cyril-bruch/desk-companion-robot/cad/print/PLATEAU_4_roues_sans_supports.stl

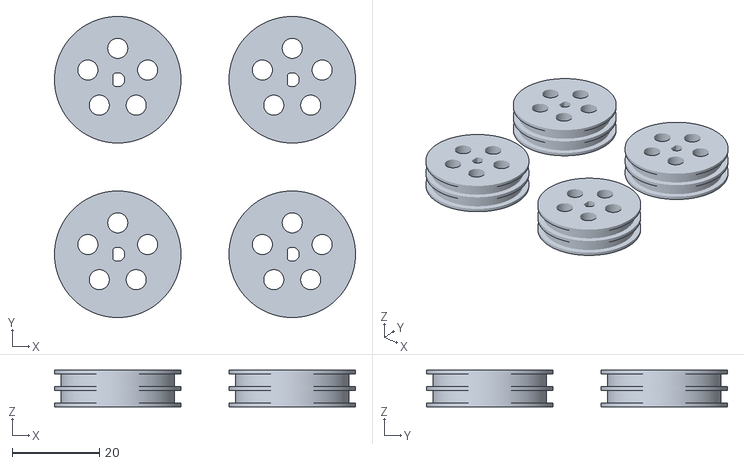
[picture p7: CAD file, 2026-10-27]
cad/print/PLATEAU_4_roues_sans_supports.stl
69.0 x 69.0 x 8.40
