cyril-bruch/desk-companion-robot/cad/print/PLATEAU_2_chassis_roues_capots.stl

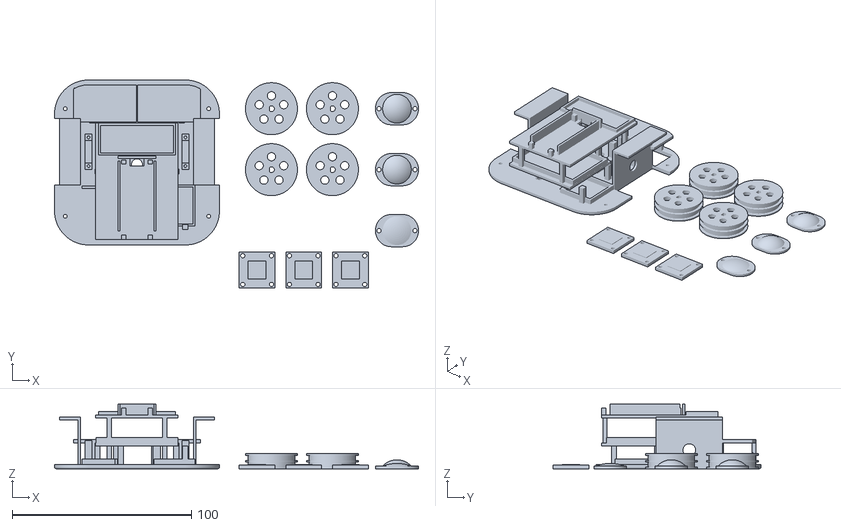
[picture p8: CAD file, 2026-10-24]
cad/print/PLATEAU_2_chassis_roues_capots.stl
203.0 x 116.0 x 36.0
