cyril-bruch/desk-companion-robot/cad/print/6b_patin_pour_feutre_2mm.stl

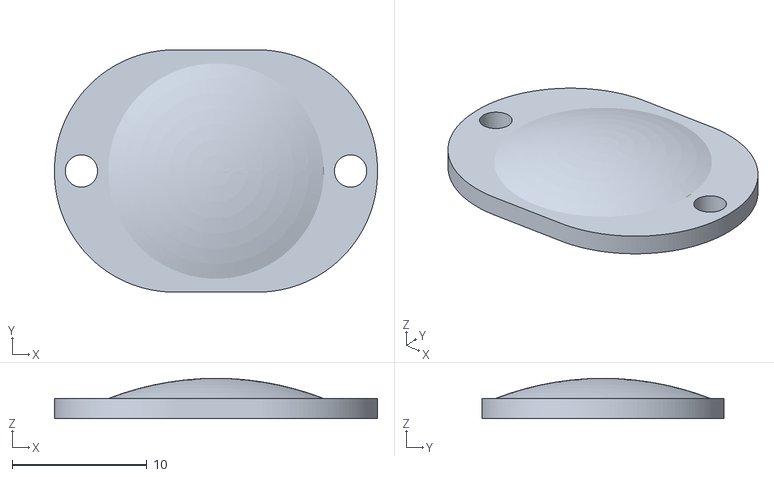
[picture p9: CAD file, 2026-10-24]
cad/print/6b_patin_pour_feutre_2mm.stl
24.0 x 18.0 x 3.00
