cyril-bruch/desk-companion-robot/cad/print/1_coque.stl

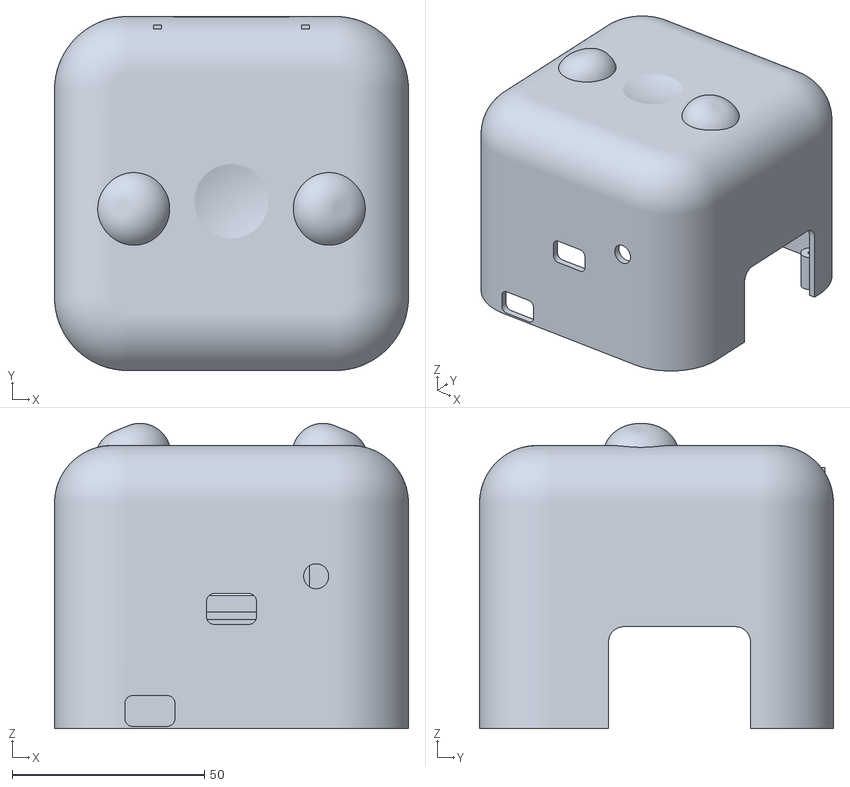
[picture p10: CAD file, 2026-10-24]
cad/print/1_coque.stl
92.0 x 92.0 x 79.3
