cyril-bruch/desk-companion-robot/cad/print/5_capot_moteur_x3.stl

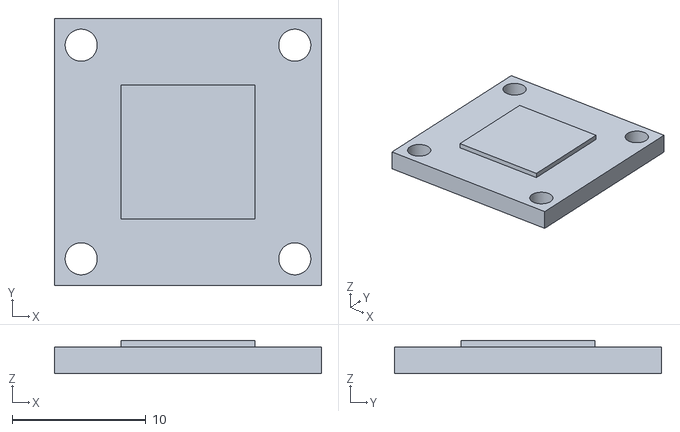
[picture p11: CAD file, 2026-10-24]
cad/print/5_capot_moteur_x3.stl
20.0 x 20.0 x 2.50
