cyril-bruch/desk-companion-robot/cad/print/4_roue_x4.stl

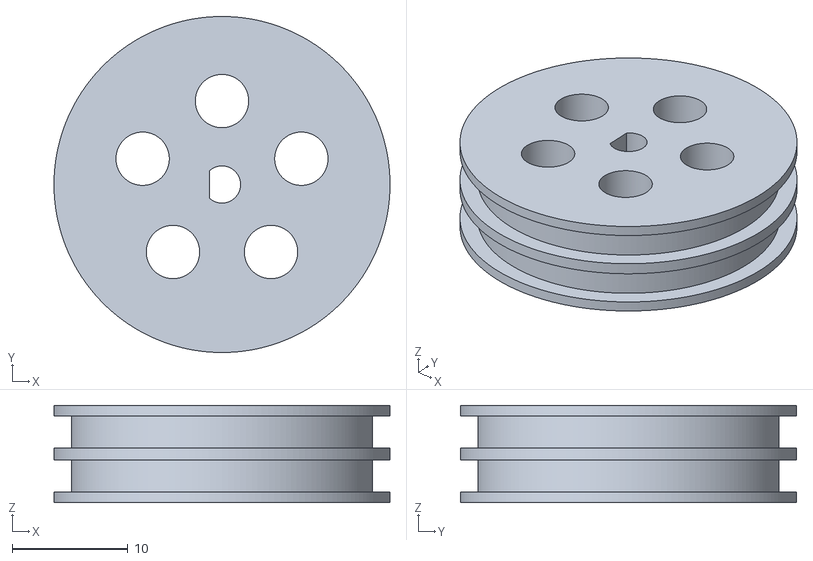
[picture p12: CAD file, 2026-10-24]
cad/print/4_roue_x4.stl
29.0 x 29.0 x 8.40
