cyril-bruch/desk-companion-robot/cad/print/6_patin_arriere_x2.stl

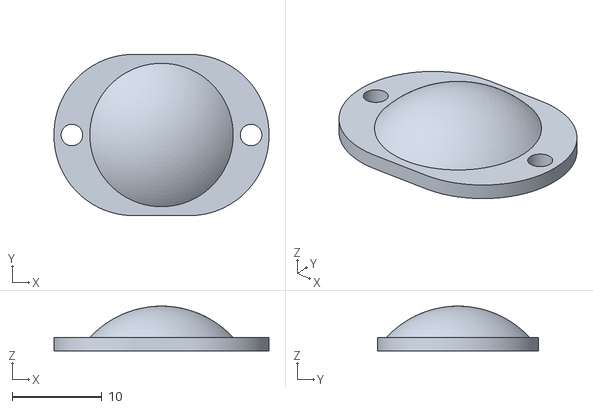
[picture p13: CAD file, 2026-10-24]
cad/print/6_patin_arriere_x2.stl
24.0 x 18.0 x 5.00
