cyril-bruch/desk-companion-robot/cad/print/2_chassis.stl

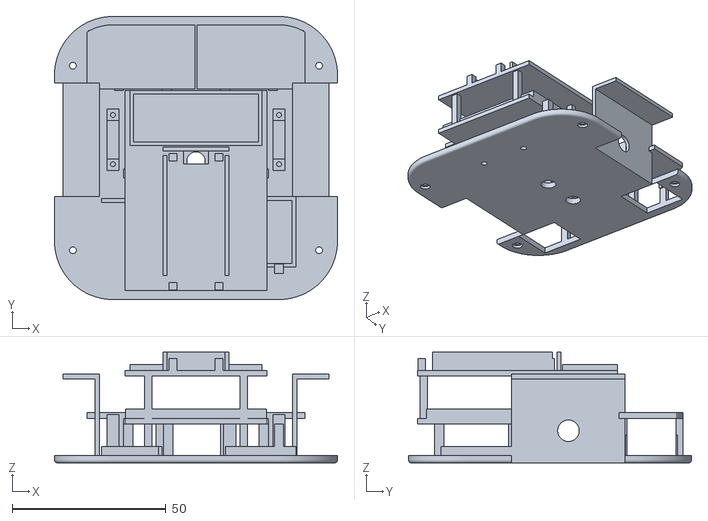
[picture p14: CAD file, 2026-10-24]
cad/print/2_chassis.stl
92.0 x 92.0 x 36.0
