cyril-bruch/desk-companion-robot/cad/print/3_facade_x2.stl

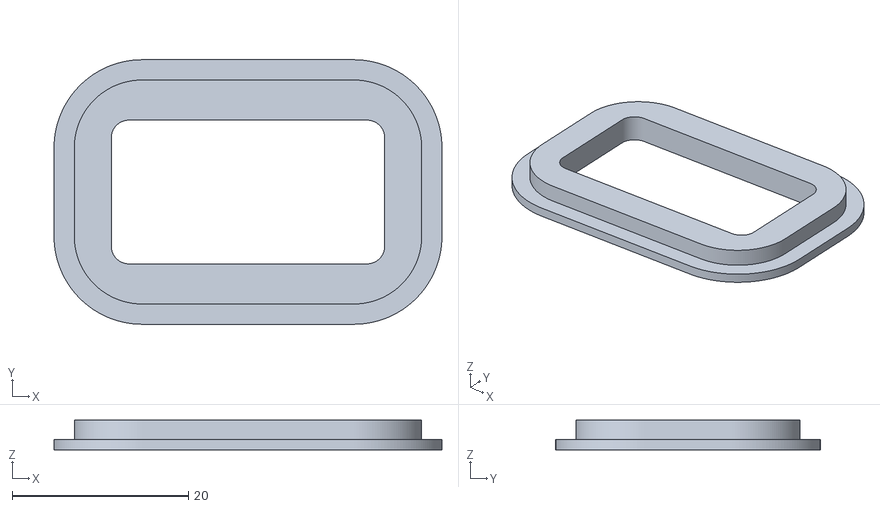
[picture p15: CAD file, 2026-10-24]
cad/print/3_facade_x2.stl
44.0 x 30.0 x 3.40
