cyril-bruch/desk-companion-robot/cad/print/PLATEAU_3_facades.stl

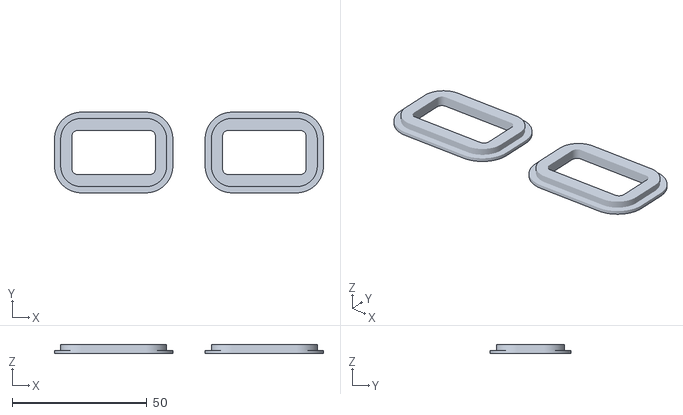
[picture p16: CAD file, 2026-10-24]
cad/print/PLATEAU_3_facades.stl
100.0 x 30.0 x 3.40
