cyril-bruch/desk-companion-robot/(list of files, cad)

Other CAD files:
cad/print/PLATEAU_1_coque.stl
