cyril-bruch/desk-companion-robot/docs/montage-ecran-caresse.png

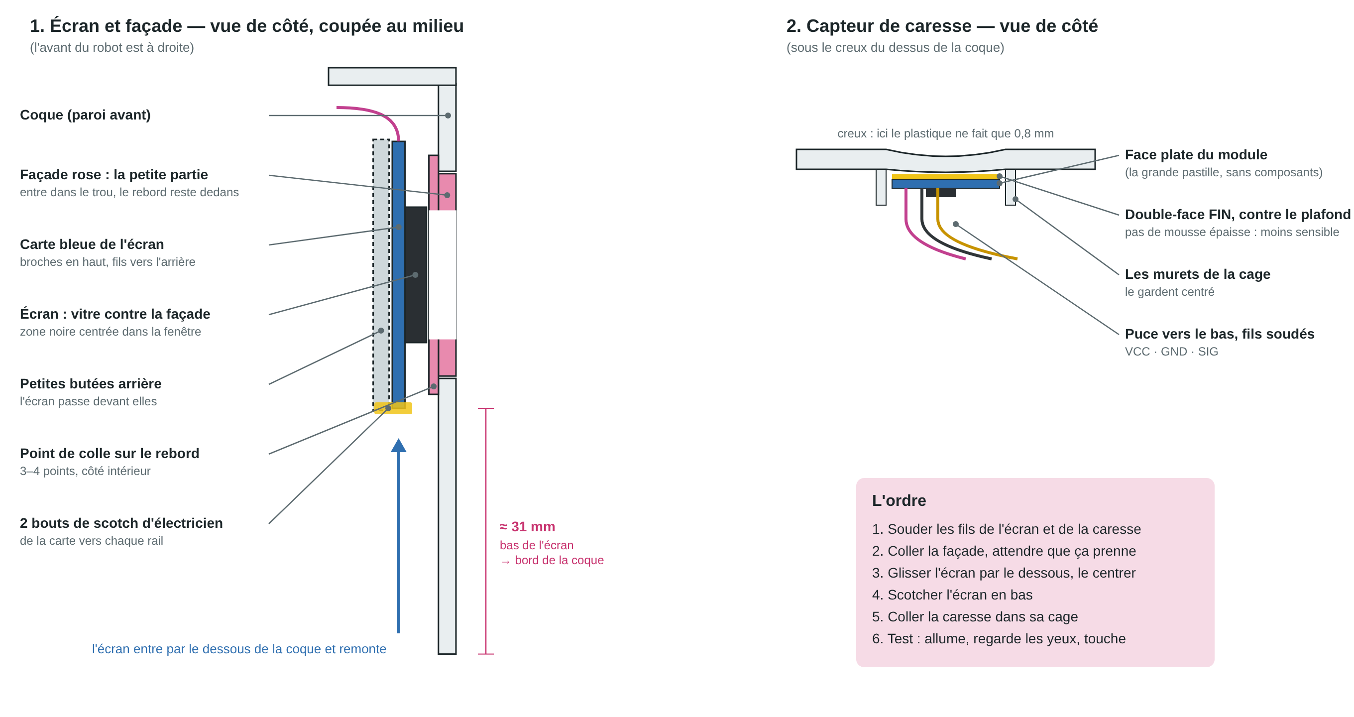
docs/montage-ecran-caresse.png
