cyril-bruch/desk-companion-robot/cad/src/robot.py

"""
Desk Companion Robot — parametric CAD (CadQuery) — v1

Axes: X = width (right +), Y = depth (front +), Z = up. Ground at Z = 0. Units: mm.
Component dimensions: docs/bom.md (AliExpress version). Where the seller does not
publish a dimension, a typical value for that kind of board is used and the bay is
oversized ("vise large"): small boards are held with double-sided tape.

Run:  python robot.py      -> ../print/*.stl (print-ready, oriented)  and  ../preview/robot.glb
"""
from pathlib import Path
import cadquery as cq

OUT = Path(__file__).resolve().parent.parent

# ============================================================== parameters
# --- body
W, D, H = 92.0, 92.0, 76.0        # outer width, depth, height (W 92: room for the motor terminals)
Z0 = 5.0                           # underside of the floor (ground clearance)
FLOOR = 2.4
WALL = 2.2
R_V, R_TOP = 19.0, 15.0            # fillets: vertical edges, top edges
TOL = 0.5                          # generous print clearance
SPLIT_Z = Z0 + FLOOR               # top of floor = bottom of the shell
Z_TOP = Z0 + H
IN_X, IN_Y = W / 2 - WALL, D / 2 - WALL      # inner wall faces

# --- parts (published dimensions unless noted)
MOTOR_L, MOTOR_W, MOTOR_H = 24.0, 12.0, 10.0  # N20 (Amazon B0DPKYCZ97): body 24 x 12 x 10 incl. gearbox
SHAFT_L = 10.0
TIRE_D = 30.9                      # printed rim (groove Ø26) + O-ring 25 x 2.5 (4 % stretch)
RIM_D, FLANGE_D, WHEEL_W = 26.0, 29.0, 8.4
GROOVE_W, GROOVES = 2.8, (0.9, 4.7)  # two O-ring grooves (x from the inner face)
OLED = (35.5, 33.5, 4.3)           # W, H, total thickness (PCB 1.6)
OLED_ACTIVE = (29.4, 14.7)
NANO = (18.0, 45.0, 1.6)
NANO_PAD = 4.0                     # Nano is flipped: clearance for its components (USB-C 3.2 mm)
BATT = (42.0, 30.0, 8.5)           # 803040 (40-42 x 30 x 8 depending on the brand: bay sized for 42)
TP4056 = (17.0, 28.0, 6.0)         # not published -> typical, bay oversized
DRV = (18.5, 18.5, 8.0)            # JZK DRV8833: 18.5 x 16 (published) -> square bay, either orientation
MT3608 = (37.0, 17.5, 12.5)        # boost 7.5 V: L x W x height incl. blue trimmer (typical, oversized)
BUZZER = (38.0, 13.0, 12.0, 10.0)  # passive buzzer module (Amazon B096ZWCG7F): 38 x 13 x 10, buzzer dia/height
BUZZER_XY = (0.0, 13.0)            # on the front extension of the Nano deck
TCRT = (32.0, 14.0, 10.0)          # module L x W, height with components
TTP = (15.0, 11.0, 1.6)
SKID_FLANGE, SKID_DOME, SKID_H = 24.0, 16.0, 3.5  # printed rear skid (replaces the ball caster)
TOGGLE = (13.0, 8.0, 10.0, 6.0)    # MTS-102: body W x H x depth, + terminals; M6 (1/4") bushing
TOGGLE_XZ = (22.0, 47.0)          # position on the rear wall

# --- layout
AXLE_Y = 6.0                       # wheels slightly in front of the centre
AXLE_Z = TIRE_D / 2
MOTOR_X1 = 31.0
MOTOR_X0 = MOTOR_X1 - MOTOR_L                     # 7 .. 31 (14 mm between the motor backs for terminals + wires)
WHEEL_X0, WHEEL_X1 = MOTOR_X1 + 2.5, MOTOR_X1 + 2.5 + WHEEL_W   # 33.5 .. 41.5 (body side at 46)
FENDER_X = MOTOR_X1 + 0.4                         # fender wall inner face
WELL_HY = TIRE_D / 2 + 3.0                        # wheel-well half length
WELL_Z = AXLE_Z + TIRE_D / 2 + 3.0
CASTER_Y = -30.0
SCREEN_Z = Z0 + 50.0
FACE_W, FACE_H, FACE_R = 40.0, 26.0, 8.0
BATT_SHELF_Z = 19.5                # top of the battery shelf
DECK_Z = 35.0                      # top of the Nano deck (room to lift the battery in)
CLIFF_SHELF_Z = 19.5               # underside of the plates the cliff sensors hang from
BOSS = [(sx * (W / 2 - 6), sy * 30.0) for sx in (-1, 1) for sy in (-1, 1)]
CRADLE_W = MOTOR_W + 8                             # motor cradle width (Y)
CAP_Z = AXLE_Z + MOTOR_H / 2 + 0.3                 # top of the cradles = underside of the cap
CAP_HOLE_DY = MOTOR_W / 2 + 2.0


# ============================================================== helpers
def box(x, y, z, cx, cy, z0):
    return cq.Workplane("XY").box(x, y, z, centered=(True, True, False)).translate((cx, cy, z0))


def bay(x, y, wall_h, cx, cy, z0, t=1.2):
    """Low open frame that locates a board (board is taped inside)."""
    return box(x + 2 * t, y + 2 * t, wall_h, cx, cy, z0).cut(box(x, y, wall_h + 1, cx, cy, z0 - 0.5))


def rounded_block(w, d, h, z, rv, rtop=0, rbot=0):
    b = box(w, d, h, 0, 0, z).edges("|Z").fillet(rv)
    if rtop:
        b = b.faces(">Z").edges().fillet(rtop)
    if rbot:
        b = b.faces("<Z").edges().fillet(rbot)
    return b


def front_xz(w, h, r, cz, depth, y_from):
    """Rounded rectangle in the XZ plane, cut/extruded toward -Y starting at y_from."""
    return (cq.Workplane("XZ").center(0, cz).rect(w, h).extrude(depth)
            .edges("|Y").fillet(r).translate((0, y_from, 0)))


CLIFF_X = (1.3, 33.3)              # module 32 x 14 (Amazon) ; hanger accepts up to 35 x 16 (kit modules)
CLIFF_Y = (26.0, 40.0)


# ============================================================== shell
def make_shell():
    s = rounded_block(W, D, H - FLOOR, SPLIT_Z, R_V, R_TOP).faces("<Z").shell(-WALL)

    for sx in (-1, 1):                                  # ears
        ear = (cq.Workplane("XY").circle(10).extrude(15).faces(">Z").edges().fillet(8)
               .rotate((0, 0, 0), (0, 1, 0), sx * 22).translate((sx * 23, -4, Z_TOP - 9.5)))
        s = s.union(ear)

    s = s.cut(front_xz(FACE_W, FACE_H, FACE_R, SCREEN_Z, 14, D / 2 + 4))   # face opening

    for sx in (-1, 1):                                  # wheel wells
        s = s.cut(box(W / 2 - FENDER_X + 2, 2 * WELL_HY, WELL_Z, sx * (FENDER_X + W / 2 + 2) / 2, AXLE_Y, 0)
                  .edges("|X").fillet(4))

    # rear openings — oversized on purpose
    s = s.cut(box(13, 12, 8, -21.2, -D / 2, SPLIT_Z + 0.6).edges("|Y").fillet(2))    # charge USB-C
    s = s.cut(box(13, 12, 8, 0, -D / 2, DECK_Z - 0.5).edges("|Y").fillet(2))         # Nano USB-C
    tx, tz = TOGGLE_XZ                                                                  # toggle switch (M6 nut)
    s = s.cut(cq.Workplane("XZ").center(tx, tz).circle(3.25).extrude(-12).translate((0, -D / 2 - 2, 0)))

    # "pet me" dimple + touch-sensor cage under it
    s = s.cut(cq.Workplane("XY").sphere(34).translate((0, -2, Z_TOP + 34 - 1.4)))
    cage = bay(TTP[0] + 2, TTP[1] + 2, 4, 0, -2, Z_TOP - WALL - 4)
    s = s.union(cage)

    # OLED pocket: side guides outside the PCB edge, back stops behind it, bottom ledge.
    # The face plate lip is the front stop (glass rests against it). PCB drops in from above.
    y_pcb_front = IN_Y - 1.2 - (OLED[2] - 1.6) - 0.3
    y_pcb_back = y_pcb_front - 1.6
    z_bot = SCREEN_Z - OLED[1] / 2 - TOL
    gx = OLED[0] / 2 + TOL                                    # guide inner face
    for sx in (-1, 1):
        guide = box(2.0, IN_Y - (y_pcb_back - TOL - 2.0), OLED[1] + 4, sx * (gx + 1.0),
                    (IN_Y + y_pcb_back - TOL - 2.0) / 2, z_bot)
        stop = box(4.0, 2.0, OLED[1] + 4, sx * (gx - 1.0), y_pcb_back - TOL - 1.0, z_bot)
        s = s.union(guide).union(stop)
    s = s.union(box(2 * gx + 4, IN_Y - (y_pcb_back - TOL - 2.0), 2.0, 0,
                    (IN_Y + y_pcb_back - TOL - 2.0) / 2, z_bot - 2.0)
                .cut(box(OLED_ACTIVE[0] + 6, 10, 6, 0, IN_Y - 1, z_bot - 3)))   # ledge (flex-cable notch)

    # keep the face-plate lip zone free (lip sits just behind the front wall)
    s = s.cut(front_xz(FACE_W + 4 + 2 * TOL, FACE_H + 4 + 2 * TOL, FACE_R + 2, SCREEN_Z, 1.2 + TOL, IN_Y + 0.001))

    for (bx, by) in BOSS:                               # screw bosses (M2 self-tapping), tied to the side wall
        sx = 1 if bx > 0 else -1
        rib = box(IN_X - abs(bx) + 1.0, 4.0, 12, sx * (abs(bx) + (IN_X - abs(bx) + 1.0) / 2), by, SPLIT_Z)
        s = s.union(rib)
        s = s.union(cq.Workplane("XY").circle(3.2).extrude(12).translate((bx, by, SPLIT_Z)))
        s = s.cut(cq.Workplane("XY").circle(0.85).extrude(13).translate((bx, by, SPLIT_Z - 0.5)))
    return s


# ============================================================== face plate (print in black)
def make_faceplate():
    p = front_xz(FACE_W - 2 * 0.3, FACE_H - 2 * 0.3, FACE_R - 0.3, SCREEN_Z, WALL, D / 2)
    p = p.union(front_xz(FACE_W + 4, FACE_H + 4, FACE_R + 2, SCREEN_Z, 1.2, D / 2 - WALL))
    return p.cut(front_xz(OLED_ACTIVE[0] + 1.6, OLED_ACTIVE[1] + 1.6, 2, SCREEN_Z, 10, D / 2 + 2))


# ============================================================== wheel (print 4: 2 + 2 spares)
def make_wheel():
    w = cq.Workplane("YZ").circle(FLANGE_D / 2).extrude(WHEEL_W)
    for x0 in GROOVES:                                  # two O-ring grooves
        groove = (cq.Workplane("YZ").circle(FLANGE_D / 2 + 1).circle(RIM_D / 2).extrude(GROOVE_W)
                  .translate((x0, 0, 0)))
        w = w.cut(groove)
    # D-shaft bore 3.2 / flat at 1.1 mm from the axis (N20: 3 mm, flat 2.5) - press fit
    bore = (cq.Workplane("YZ").circle(1.6).extrude(WHEEL_W + 2).translate((-1, 0, 0))
            .cut(box(WHEEL_W + 4, 4, 2, WHEEL_W / 2, 0, 1.1)))
    w = w.cut(bore)
    # lightening holes = cute "rims"
    for i in range(5):
        import math
        a = 2 * math.pi * i / 5
        w = w.cut(cq.Workplane("YZ").circle(2.3).extrude(WHEEL_W + 2)
                  .translate((-1, 7.2 * math.cos(a), 7.2 * math.sin(a))))
    return w   # local frame: x 0..WHEEL_W, axis on X


# ============================================================== motor cap (print 3: 2 + 1 spare)
def make_motor_cap():
    x0, x1 = MOTOR_X0 + 2, MOTOR_X1 - 2
    cap = box(x1 - x0, CRADLE_W, 2.0, (x0 + x1) / 2, 0, 0)
    cap = cap.union(box(x1 - x0 - 10, MOTOR_W - 2, 0.5, (x0 + x1) / 2, 0, -0.5))   # presses the motor (0.2 mm)
    for x in (MOTOR_X0 + 4, MOTOR_X1 - 4):
        for dy in (-CAP_HOLE_DY, CAP_HOLE_DY):
            cap = cap.cut(cq.Workplane("XY").circle(1.2).extrude(4).translate((x, dy, -1)))
    return cap   # local frame: right motor, y centred on the axle, z = 0 at the cradle tops


# ============================================================== rear skid (print 2: 1 + 1 spare)
FELT = 2.0   # optional felt pad glued under the skid (silent, no scratches): variant 6b is lower by this much


def make_skid(h=SKID_H):
    """Flange screwed under the floor + smooth dome that slides on the desk.
    Local frame: flange top at z = 0, dome pointing down to z = -(1.5 + h).
    h = SKID_H: bare plastic skid; h = SKID_H - FELT: flatter dome to carry a felt pad."""
    r = ((SKID_DOME / 2) ** 2 + h ** 2) / (2 * h)                    # sphere radius of the cap
    flange = box(SKID_FLANGE, 18, 1.5, 0, 0, -1.5).edges("|Z").fillet(8.9)
    cap = (cq.Workplane("XY").sphere(r).translate((0, 0, -1.5 - h + r))
           .intersect(box(40, 40, h, 0, 0, -1.5 - h)))
    skid = flange.union(cap)
    for dx in (-10.0, 10.0):
        skid = skid.cut(cq.Workplane("XY").circle(1.2).extrude(4).translate((dx, 0, -3)))
    return skid


# ============================================================== chassis
def make_chassis():
    c = rounded_block(W, D, FLOOR, Z0, R_V, 0, 1.0)

    for sx in (-1, 1):
        # wheel well through the floor + fender wall with shaft hole + well roof
        c = c.cut(box(W / 2 - FENDER_X + 2, 2 * WELL_HY, 20, sx * (FENDER_X + W / 2 + 2) / 2, AXLE_Y, 0))
        fx = sx * (FENDER_X + 0.7)
        fender = box(1.4, 2 * WELL_HY, WELL_Z - Z0, fx, AXLE_Y, Z0)
        fender = fender.cut(cq.Workplane("YZ").circle(3.5).extrude(6).translate((fx - 3, AXLE_Y, AXLE_Z)))
        c = c.union(fender)
        c = c.union(box(IN_X - TOL - FENDER_X - 1.4, 2 * WELL_HY, 1.6,
                        sx * (FENDER_X + 1.4 + (IN_X - TOL - FENDER_X - 1.4) / 2), AXLE_Y, WELL_Z - 1.6))

        # motor cradles (2 per motor), open on top: the motor drops in, then a printed
        # cap is screwed on top (2 x M2 self-tapping per cradle)
        for x in (MOTOR_X0 + 4, MOTOR_X1 - 4):
            u = box(4, CRADLE_W, CAP_Z - SPLIT_Z, sx * x, AXLE_Y, SPLIT_Z)
            u = u.cut(box(5, MOTOR_W + TOL, 30, sx * x, AXLE_Y, AXLE_Z - MOTOR_H / 2))
            for dy in (-CAP_HOLE_DY, CAP_HOLE_DY):
                u = u.cut(cq.Workplane("XY").circle(0.8).extrude(7).translate((sx * x, AXLE_Y + dy, CAP_Z - 6.9)))
            c = c.union(u)

        # cliff sensor hanger: plate under which the TCRT5000 module is taped (components down)
        x0, x1 = CLIFF_X
        cx = sx * (x0 + x1) / 2
        px0, px1 = x0 - 1.0, 35.5
        plate = box(px1 - px0, CLIFF_Y[1] - CLIFF_Y[0] + 7, 1.8, sx * (px0 + px1) / 2, sum(CLIFF_Y) / 2, CLIFF_SHELF_Z)
        c = c.union(plate)
        for (px, py) in ((9.5, CLIFF_Y[0] - 2.5), (25.0, CLIFF_Y[0] - 2.5), (9.5, CLIFF_Y[1] + 2.5), (25.0, CLIFF_Y[1] + 2.5)):
            c = c.union(box(3, 3, CLIFF_SHELF_Z - SPLIT_Z, sx * px, py, SPLIT_Z))
        # light window under the sensor end (outer end), oversized
        c = c.cut(box(18, 17, 10, sx * 26.0, sum(CLIFF_Y) / 2, Z0 - 1))           # sensor end anywhere in x 17..35

    # rear skid (printed, screwed under the floor with 2 x M2 + nuts)
    for dx in (-10.0, 10.0):
        c = c.cut(cq.Workplane("XY").circle(1.2).extrude(FLOOR + 2).translate((dx, CASTER_Y, Z0 - 1)))

    # floor-level bays (boards taped inside)
    # charger: L-shaped stop (front + inner side), USB-C end free toward the rear opening
    CH_X, CH_Y0 = -21.2, -IN_Y + 0.9                  # board centre x, rear edge y (port close to the wall)
    c = c.union(box(TP4056[0] + 2, 1.2, 3, CH_X, CH_Y0 + TP4056[1] + TOL + 0.6, SPLIT_Z))
    c = c.union(box(1.2, TP4056[1] * 0.6, 3, CH_X + TP4056[0] / 2 + TOL + 0.6, CH_Y0 + TP4056[1] * 0.7, SPLIT_Z))
    c = c.union(bay(DRV[0] + 2, DRV[1] + 2, 3, 21.0, -24.0, SPLIT_Z))

    # battery shelf, 3 posts + cantilever over the charger
    shelf_y0, shelf_y1 = -IN_Y + 0.8, -3.5
    c = c.union(box(46, shelf_y1 - shelf_y0, 1.8, 0, (shelf_y0 + shelf_y1) / 2, BATT_SHELF_Z - 1.8))
    c = c.union(bay(BATT[0] + 1.5, BATT[1] + 1.5, 3, 0, (shelf_y0 + shelf_y1) / 2, BATT_SHELF_Z))
    for (px, py) in ((22, -5), (-22, -5), (27, -36), (-9, -12)):
        c = c.union(box(3, 3, BATT_SHELF_Z - 1.8 - SPLIT_Z, px, py, SPLIT_Z))

    # Nano deck (posts on the battery shelf + 2 front posts on the floor).
    # Nano: USB-C 0.6 mm from the rear wall, right behind the rear opening (cable plugs in from outside).
    deck_y0, deck_y1 = -IN_Y + 0.8, 22.0
    c = c.union(box(46, deck_y1 - deck_y0, 1.8, 0, (deck_y0 + deck_y1) / 2, DECK_Z - 1.8))
    # Nano mounted UPSIDE DOWN (header pins up, Dupont plugs from above), resting on 4 corner
    # pads that touch only the pin-free ends of the board; USB-C hangs below, at the opening.
    ny0, ny1 = -IN_Y + 0.6, -IN_Y + 0.6 + NANO[1]
    for py in (ny0 + 1.5, ny1 - 1.5):
        for sx in (-1, 1):
            c = c.union(box(2.6, 2.4, NANO_PAD, sx * 7.4, py, DECK_Z))
    for sx in (-1, 1):                                   # side guides outside the board
        c = c.union(box(1.2, NANO[1] - 6, NANO_PAD + 2, sx * (NANO[0] / 2 + TOL + 0.6), (ny0 + ny1) / 2 + 2, DECK_Z))
    c = c.union(box(NANO[0] + 2 * TOL + 2.4, 1.2, NANO_PAD + 2, 0, ny1 + TOL + 0.6, DECK_Z))   # front stop
    for (px, py) in ((15.5, -6), (-15.5, -6), (15.5, deck_y0 + 2), (-15.5, deck_y0 + 2)):
        c = c.union(box(2.5, 2.5, DECK_Z - 1.8 - BATT_SHELF_Z, px, py, BATT_SHELF_Z))
    for px in (15.5, -15.5):                             # front posts down to the floor
        c = c.union(box(2.5, 2.5, DECK_Z - 1.8 - SPLIT_Z, px, 20.0, SPLIT_Z))
    # buzzer module bay on the deck extension
    bx, by = BUZZER_XY
    c = c.union(bay(BUZZER[0] + 2.5, BUZZER[1] + 2.5, 2, bx, by, DECK_Z))

    # wire passages
    for (hx, hy) in ((0, -1), (0, 15)):
        c = c.cut(cq.Workplane("XY").circle(3).extrude(5).translate((hx, hy, Z0 - 1)))
    c = c.cut(box(8, 5, 4, 0, -6, BATT_SHELF_Z - 2.5))
    c = c.cut(box(8, 5, 4, 0, 0.5, DECK_Z - 2.5))

    # everything above the floor must stay inside the shell (with clearance)
    env = rounded_block(W - 2 * (WALL + TOL), D - 2 * (WALL + TOL), 200, SPLIT_Z - 0.01, R_V - WALL - TOL)
    env = env.union(rounded_block(W, D, FLOOR + 0.02, Z0 - 0.01, R_V))
    c = c.intersect(env)

    for (bx, by) in BOSS:                               # screw holes
        c = c.cut(cq.Workplane("XY").circle(1.1).extrude(10).translate((bx, by, Z0 - 1)))
        c = c.cut(cq.Workplane("XY").circle(2.0).extrude(1.2).translate((bx, by, Z0 - 0.01)))  # head recess
    return c


# ============================================================== non-printed parts (preview only)
def make_parts():
    p = {}
    def u(a, b):
        return b if a is None else a.union(b)

    mot = tires = None
    for sx in (-1, 1):
        mot = u(mot, box(MOTOR_L, MOTOR_W, MOTOR_H, sx * (MOTOR_X0 + MOTOR_L / 2), AXLE_Y, AXLE_Z - MOTOR_H / 2))
        mot = mot.union(cq.Workplane("YZ").circle(1.5).extrude(SHAFT_L)
                        .translate((MOTOR_X1 if sx > 0 else -MOTOR_X1 - SHAFT_L, AXLE_Y, AXLE_Z)))
        for x0 in GROOVES:
            xs = (WHEEL_X0 + x0) if sx > 0 else -(WHEEL_X0 + x0 + GROOVE_W)
            tires = u(tires, cq.Workplane("YZ").circle(TIRE_D / 2).circle(RIM_D / 2).extrude(GROOVE_W)
                      .translate((xs, AXLE_Y, AXLE_Z)))
    p["motors"] = (mot, (0.72, 0.72, 0.76))
    p["tires"] = (tires, (0.12, 0.12, 0.14))

    sy0 = -IN_Y + 0.8
    p["battery"] = (box(*BATT, 0, (sy0 - 3.5) / 2, BATT_SHELF_Z + 0.2), (0.85, 0.75, 0.25))
    ncy = -IN_Y + 0.6 + NANO[1] / 2
    nano = box(*NANO, 0, ncy, DECK_Z + NANO_PAD)                                   # board (flipped)
    nano = nano.union(box(9.0, 7.5, 3.2, 0, -IN_Y + 0.6 + 3.75, DECK_Z + NANO_PAD - 3.2))   # USB-C below
    for sx in (-1, 1):                                                             # header pins up
        nano = nano.union(box(2.5, 38.1, 8.5, sx * 7.62, ncy, DECK_Z + NANO_PAD + 1.6))
    p["nano"] = (nano, (0.0, 0.55, 0.6))
    p["charger"] = (box(TP4056[0], TP4056[1], 1.6, -21.2, -IN_Y + 0.9 + TP4056[1] / 2, SPLIT_Z + 0.2)
                    .union(box(9, 7.5, 3.2, -21.2, -IN_Y + 0.9 + 3.75, SPLIT_Z + 1.8)), (0.15, 0.3, 0.75))
    p["driver"] = (box(18.5, 16.0, 1.6, 21.0, -24.0, SPLIT_Z + 0.2), (0.12, 0.12, 0.14))
    # MT3608 taped on top of the two front sensor plates (spans both)
    mt = box(MT3608[0], MT3608[1], 1.6, 0, 33.0, CLIFF_SHELF_Z + 1.8 + 0.2)
    mt = mt.union(box(9.5, 4.5, MT3608[2] - 1.6, -9, 33.0 + 4, CLIFF_SHELF_Z + 1.8 + 1.8))   # trimmer
    p["boost"] = (mt, (0.15, 0.3, 0.75))
    bx, by = BUZZER_XY
    bz = box(BUZZER[0], BUZZER[1], 1.6, bx, by, DECK_Z + 0.2)
    bz = bz.union(cq.Workplane("XY").circle(BUZZER[2] / 2).extrude(BUZZER[3]).translate((bx - BUZZER[0] / 2 + 7, by, DECK_Z + 1.8)))
    bz = bz.union(box(2.6, 8, 11, bx + BUZZER[0] / 2 - 2, by, DECK_Z + 1.8))      # header pins
    p["buzzer"] = (bz, (0.12, 0.12, 0.14))
    tx, tz = TOGGLE_XZ
    tg = box(TOGGLE[0], TOGGLE[2] + TOGGLE[3], TOGGLE[1], tx, -IN_Y + (TOGGLE[2] + TOGGLE[3]) / 2 + 0.3, tz - TOGGLE[1] / 2)
    tg = tg.union(cq.Workplane("XZ").center(tx, tz).circle(3.0).extrude(8).translate((0, -IN_Y, 0)))   # M6 bushing, outward
    p["switch"] = (tg, (0.25, 0.25, 0.28))
    cliff = None
    for sx in (-1, 1):
        x0, x1 = CLIFF_X
        pcb = box(TCRT[0], TCRT[1], 1.6, sx * (x0 + x1) / 2, sum(CLIFF_Y) / 2, CLIFF_SHELF_Z - 1.6)
        eye = box(10, 6, 7.5, sx * (x1 - 6), sum(CLIFF_Y) / 2, CLIFF_SHELF_Z - 1.6 - 7.5)
        cliff = u(cliff, pcb.union(eye))
    p["cliff_sensors"] = (cliff, (0.1, 0.45, 0.2))
    p["touch"] = (box(*TTP, 0, -2, Z_TOP - WALL - 1.4 - TTP[2] - 0.3), (0.75, 0.15, 0.15))

    y_pcb_front = IN_Y - 1.2 - (OLED[2] - 1.6) - 0.3
    p["oled_pcb"] = (front_xz(OLED[0], OLED[1], 0.5, SCREEN_Z, 1.6, y_pcb_front), (0.1, 0.25, 0.6))
    p["screen"] = (front_xz(OLED_ACTIVE[0] + 4, OLED_ACTIVE[1] + 5, 0.5, SCREEN_Z, OLED[2] - 1.6, y_pcb_front + OLED[2] - 1.6),
                   (0.03, 0.03, 0.05))
    eyes = None
    for sx in (-1, 1):
        eyes = u(eyes, (cq.Workplane("XZ").center(sx * 7.5, SCREEN_Z).rect(7, 10).extrude(0.3)
                        .edges("|Y").fillet(2.5).translate((0, y_pcb_front + OLED[2] - 1.6 + 0.3, 0))))
    p["eyes"] = (eyes, (0.75, 0.95, 1.0))
    return p


def build():
    shell, chassis, face, wheel = make_shell(), make_chassis(), make_faceplate(), make_wheel()
    cap = make_motor_cap()
    skid = make_skid()
    skid_felt = make_skid(SKID_H - FELT)
    parts = make_parts()
    (OUT / "preview").mkdir(exist_ok=True)

    # print-ready copies: each part laid in its print orientation, sitting on z = 0
    pr = OUT / "print"
    pr.mkdir(exist_ok=True)
    def on_bed(solid):
        bb = solid.val().BoundingBox()
        return solid.translate((-(bb.xmin + bb.xmax) / 2, -(bb.ymin + bb.ymax) / 2, -bb.zmin))
    printable = {
        "1_coque": on_bed(shell),                                               # opening down
        "2_chassis": on_bed(chassis),                                           # floor down
        "3_facade_x2": on_bed(face.rotate((0, 0, 0), (1, 0, 0), 90)),           # front face down
        "4_roue_x4": on_bed(wheel.rotate((0, 0, 0), (0, 1, 0), -90)),           # axis vertical
        "5_capot_moteur_x3": on_bed(cap.rotate((0, 0, 0), (1, 0, 0), 180)),     # flat face down
        "6_patin_arriere_x2": on_bed(skid.rotate((0, 0, 0), (1, 0, 0), 180)),   # flange down, dome up
        "6b_patin_pour_feutre_2mm": on_bed(skid_felt.rotate((0, 0, 0), (1, 0, 0), 180)),
    }
    for name, solid in printable.items():
        cq.exporters.export(solid, str(pr / f"{name}.stl"), tolerance=0.03, angularTolerance=0.08)

    # mesh clean-up (a sphere pole can leave a degenerate triangle) + ready-made plates
    # for the FlashForge Dreamer bed (230 x 150 mm, origin at the centre of the bed)
    try:
        import trimesh
        meshes = {}
        for name in printable:
            m = trimesh.load(str(pr / f"{name}.stl"))
            m.update_faces(m.nondegenerate_faces()); m.merge_vertices(); m.remove_unreferenced_vertices()
            trimesh.repair.fill_holes(m); trimesh.repair.fix_normals(m)
            m.export(str(pr / f"{name}.stl"))
            meshes[name] = m
        def place(m, x, y):
            c = m.copy(); b = c.bounds
            c.apply_translation((x - (b[0][0] + b[1][0]) / 2, y - (b[0][1] + b[1][1]) / 2, -b[0][2]))
            return c
        plates = {
            "PLATEAU_1_coque": [place(meshes["1_coque"], 0, 0)],
            "PLATEAU_2_chassis_roues_capots": [place(meshes["2_chassis"], -45, 10)]
                + [place(meshes["4_roue_x4"], 30 + 34 * (i % 2), 40 - 34 * (i // 2)) for i in range(4)]
                + [place(meshes["5_capot_moteur_x3"], 22 + 26 * i, -50) for i in range(3)]
                + [place(meshes["6_patin_arriere_x2"], 100, 40 - 34 * i) for i in range(2)]
                + [place(meshes["6b_patin_pour_feutre_2mm"], 100, -28)],
            "PLATEAU_3_facades": [place(meshes["3_facade_x2"], x, 0) for x in (-28, 28)],
            # wheels alone, printed WITHOUT supports (the only overhangs are the 1.5 mm groove ceilings)
            "PLATEAU_4_roues_sans_supports": [place(meshes["4_roue_x4"], 20 * (2 * (i % 2) - 1), 20 * (2 * (i // 2) - 1)) for i in range(4)],
        }
        for name, pieces in plates.items():
            combo = trimesh.util.concatenate(pieces)
            lo, hi = combo.bounds
            assert -115 <= lo[0] and hi[0] <= 115 and -75 <= lo[1] and hi[1] <= 75 and hi[2] <= 140, name
            combo.export(str(pr / f"{name}.stl"))
    except ImportError:
        print("trimesh not installed: plates not generated")

    assy = cq.Assembly(name="robot")
    assy.add(shell, name="shell", color=cq.Color(0.96, 0.93, 0.88))
    assy.add(chassis, name="chassis", color=cq.Color(0.98, 0.72, 0.68))
    assy.add(face, name="faceplate", color=cq.Color(0.10, 0.10, 0.12))
    for sx in (-1, 1):
        wloc = wheel.translate((WHEEL_X0, AXLE_Y, AXLE_Z)) if sx > 0 else \
            wheel.mirror("YZ").translate((-WHEEL_X0, AXLE_Y, AXLE_Z))
        assy.add(wloc, name=f"wheel_{'r' if sx > 0 else 'l'}", color=cq.Color(0.98, 0.72, 0.68))
    for sx in (-1, 1):
        cl = cap.translate((0, AXLE_Y, CAP_Z)) if sx > 0 else cap.mirror("YZ").translate((0, AXLE_Y, CAP_Z))
        assy.add(cl, name=f"motor_cap_{'r' if sx > 0 else 'l'}", color=cq.Color(0.98, 0.72, 0.68))
    assy.add(skid.translate((0, CASTER_Y, Z0)), name="skid", color=cq.Color(0.98, 0.72, 0.68))
    for n, (s, col) in parts.items():
        assy.add(s, name=n, color=cq.Color(*col))
    assy.save(str(OUT / "preview" / "robot.glb"))
    return shell, chassis, face, wheel, parts


if __name__ == "__main__":
    s, c, f, w, parts = build()
    bb = s.val().BoundingBox()
    print("shell bbox", round(bb.xlen, 1), round(bb.ylen, 1), round(bb.zmax, 1))
    vol = {n: round(x.val().Volume() / 1000, 1) for n, x in (("shell", s), ("chassis", c), ("face", f), ("wheel", w))}
    print("volumes cm3", vol)
    # interference check between the printed parts and the purchased parts
    printed = {"shell": s, "chassis": c}
    for pn, ps in printed.items():
        for n, (part, _) in parts.items():
            try:
                v = ps.intersect(part).val().Volume()
            except Exception:
                v = 0
            if v > 1.0:
                print(f"  CLASH {pn} x {n}: {v:.1f} mm3")
