cyril-bruch/desk-companion-robot/simulink/blocks/buzzer/Buzzer_tone/Buzzer_tone.h

#ifndef BUZZER_TONE_H
#define BUZZER_TONE_H
#include "rtwtypes.h"
#ifdef __cplusplus
extern "C" {
#endif
    void stepFunctionBuzzer_tone(double freq,int size_vector_a);
    void setupFunctionBuzzer_tone(int8_T  pin,int size_vector__1);
#ifdef __cplusplus
}
#endif
#endif
