cyril-bruch/desk-companion-robot/simulink/blocks/oled/Oled_eyes/Oled_eyes.h

/* Copyright 2023 The MathWorks, Inc. */
#ifndef EXAMPLE_H
#define EXAMPLE_H
#include "rtwtypes.h"
#ifdef __cplusplus
extern "C" {
    #endif
    void stepFunctionOled_eyes(double face,int size_vector_a);
    void setupFunctionOled_eyes(int8_T  BlockParameter,int size_vector__1);
    #ifdef __cplusplus
}
#endif
#endif
