cyril-bruch/desk-companion-robot/(commit log)

2026-10-23 Initial project structure
    Add README, Simulink-oriented .gitignore, requirements and BOM draft,
    and folder layout for CAD, electronics and Simulink models.
    Claude-Session: https://claude.ai/code/session_017zonqwha4aEK19jRwqcfqP
2026-10-23 Add bill of materials for v1
    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
2026-10-23 Update BOM with exact part references and CAD dimensions
    All parts bought new. Precision parts (board, motor driver, regulator,
    wheels, caster, cliff sensors) sourced from RobotShop EU with documented
    dimensions; standard parts from Amazon with exact specs.
    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
2026-10-23 BOM: replace out-of-stock regulator, add soldering kit
    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
2026-10-23 BOM: direct verified links for every part
    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
2026-10-23 Add parametric CAD model v0 (shell, face plate, chassis)
    CadQuery source with all component dimensions from the BOM, exported
    STLs and a GLB preview used by the interactive 3D viewer.
    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
    [chassis.stl, faceplate.stl, shell.stl]
2026-10-23 BOM: switch to AliExpress sourcing (~55 EUR incl. tools)
    Printed wheels with O-ring tyres, TPS61023 fixed 5V boost, TCRT5000
    cliff sensors. Every link, price and dimension checked on the listing.
    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
2026-10-23 BOM: soldering kit option with solder wire, add double-sided tape
    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
2026-10-23 CAD v1: layout for the AliExpress parts, printed wheels, print guide
    - Body 86x92x87, wheels slightly forward, caster at the rear
    - Printed wheels with two O-ring tyres, D-shaft press fit
    - Oversized bays for boards without published dimensions (taped)
    - Cliff sensors hang under front plates, touch sensor cage under the dimple
    - OLED pocket uses the face plate as front stop
    - Interference checks: no clash between printed and purchased parts
    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
    [chassis.stl, faceplate.stl, shell.stl, wheel.stl]
2026-10-24 Assembly and wiring guide, open-top motor cradles with screwed caps
    - Motors could not be inserted in closed clamps: cradles are now open on
    top and held by printed caps (2 x M2 each)
    - Nano deck raised to 35 mm so the battery can be lifted into its frame
    - Power via VIN at 7.5 V (MT3608), since the Nano R4 docs do not cover
    powering through the 5V pin
    - docs/assemblage.md: layout, power, pin map, assembly order
    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
    [chassis.stl, motor_cap.stl, shell.stl]
2026-10-24 Add passive piezo buzzer, MT3608 replaces TPS61023, full consistency pass
    - Buzzer on D3 in a floor ring with a sound grille; MT3608 taped on top of
    the front sensor plates (both modelled and clash-checked)
    - Pin map, power budget, screw/hole table in docs/assemblage.md
    - No interference between printed parts, purchased parts, or each other
    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
    [chassis.stl]
2026-10-24 Buzzer module and MT3608 sourced, USB-C ports flush with the rear openings
    - MH-FMD passive buzzer module on a front extension of the Nano deck
    (2 extra deck posts); floor buzzer ring removed
    - MT3608 height 12.5 mm (blue trimmer), re-checked against the OLED
    - Nano and charger pushed against the rear wall: cables plug in from
    outside with the robot closed
    - Assembly guide: programming strategy section
    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
    [chassis.stl]
2026-10-24 v1 print-ready release after full electrical and mechanical review
    Fixes found by the review:
    - Body 92 mm wide: 10 mm between the motor backs for terminals and wires
    - Shell screw bosses were floating: now tied to the side wall
    - Power switch SS12D00 (0.5 A) replaced by MTS-102 toggle (6 A), rear wall
    - Nano R4 with headers mounted upside down on corner pads (pins up)
    - Wiring notes: soldered wires on DRV8833 and cliff sensors, all grounds
    on TP4056 OUT-, buzzer idle HIGH
    Print files: oriented STLs and ready-made plates for the FlashForge
    Dreamer in cad/print/, FlashPrint settings in docs/impression.md.
    All parts are single watertight solids; no interference found.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
    [1_coque.stl, 2_chassis.stl, 3_facade_x2.stl, 4_roue_x4.stl, 5_capot_moteur_x3.stl, PLATEAU_1_coque.stl, PLATEAU_2_chassis_roues_capots.stl, PLATEAU_3_facades_noir.stl]
2026-10-24 Amazon sourcing: parts re-dimensioned, printed rear skid, 5C battery
    - Single Amazon order (EU per-parcel duties made AliExpress too expensive)
    - 24 mm N20 motors, O-ring tyres 25x2.5, printed skid replaces the ball caster
    - Battery bay widened for the 42x30x8 5C LiPo (motor stall peaks ~2 A)
    - New module sizes (DRV8833, MT3608, buzzer), TCRT5000 kit boards accepted up to 35x16
    - Full clash / keep-out / watertightness re-check, docs updated
    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
    [1_coque.stl, 2_chassis.stl, 4_roue_x4.stl, 5_capot_moteur_x3.stl, 6_patin_arriere_x2.stl, PLATEAU_1_coque.stl, PLATEAU_2_chassis_roues_capots.stl]
2026-10-24 Add a felt-ready rear skid variant (2 mm lower) for silent sliding
    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
    [6b_patin_pour_feutre_2mm.stl, PLATEAU_2_chassis_roues_capots.stl]
2026-10-24 BOM: TCRT5000 cliff sensors now bought (Amazon lot of 5), totals updated
    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
2026-10-24 BOM: O-ring tyres from a seller shipped by Amazon (same 25x2.5 size)
    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
2026-10-24 Wire-routing check: 13 runs verified with a 4 mm bundle, routing notes
    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
2026-10-24 Print guide rewritten for Ultimaker Cura (FlashPrint kept as fallback)
    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
2026-10-24 Print guide: FlashPrint 5 on Cyril's PC, white + pink colour plan, .gx output
    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
    [PLATEAU_3_facades.stl]
2026-10-24 Print guide: FlashPrint support dialog names as they really appear
    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
2026-10-26 Assembly: OLED slides in from below and is taped (pocket finding on the printed v1)
    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
2026-10-26 Assembly: OLED header pins cut to 3 mm, wires soldered (fits its rails)
    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
2026-10-27 Plate 4: wheels alone, printed without supports (plate 2 supports filled the grooves)
    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
    [PLATEAU_4_roues_sans_supports.stl]
2026-10-27 Battery sense on A0 taken after the switch (no back-powering when off)
    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
2026-10-27 README credits: Simulink by Cyril, 3D + visual design (eyes, sounds, driver blocks) by AI
    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
2026-10-29 Simulink model, driver blocks and wiring map
    - DesktopRobotSimuModel: Stateflow chart + sensors, ACTIONNEURS (motion
    generator, soft start, DRV8833 table, PWM D10 D9 D6 D5), sound player,
    battery filter; pins as wired (touch D11, cliffs D8/D7, OLED A4/A5)
    - params.m with every constant and the pin map
    - IO Device Builder blocks: Oled_eyes (U8g2) and Buzzer_tone
    - docs/cablage.html: clickable wiring map, build order and tests
    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
    [Buzzer_tone.cpp, Buzzer_tone.h, Oled_eyes.cpp, Oled_eyes.h]
2026-10-30 Gentler dance (one wheel at a time), softer buzzer (one octave lower)
    The dance reversed both motors at once and the current spike reset the Nano.
    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
2026-10-30 Safety: watchdog in the buzzer block, short coast between moves, slower speeds
    The Nano could freeze on a motor current spike (reversing after an edge) and keep
    the last PWM: the robot kept reversing. Now the WDT resets it after ~1.4 s.
    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
    [Buzzer_tone.cpp]
2026-10-30 motionGen: coast gap only when the command changes (separate timer)
    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
2026-10-30 motor voltage corection
2026-10-30 Model: coast gap in motionGen, watchdog compiled; params merged with Cyril's tuning
    - motionGen block updated from mlfcn (0.2 s coast when the command changes)
    - update_fcn_blocks.m: pushes mlfcn/*.m into the MATLAB Function blocks
    without rebuilding the model (keeps the block signature with its parameters)
    - params: Cyril's dirLeft/dirRight = -1 kept, speedBack 0.35
    - Build checked: compiles for the Nano R4 (25.8 % flash), only the upload
    was skipped (board not plugged)
    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
2026-10-30 Wander: gentle curves instead of spinning, never reverses; hw_test model script
    - motionGen: curve = outer wheel speedTurn, inner wheel 30 %; both wheels forward
    - params: speedTurn 0.45, curves 0.6-1.5 s, wanderTurnProb 0.5
    - make_hw_test.m: test model (each DRV8833 input alone, cliff sensors on the eyes)
    to check the wiring before touching the edge behaviour
    (model block not updated yet: run update_fcn_blocks.m once the PC is linked)
    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
2026-10-30 Wiring checked on the robot with hw_test: right motor direction and cliff sensor sides fixed
    hw_test results: IN1 left back, IN2 left fwd, IN3 right fwd, IN4 right back;
    left cliff sensor on D7, right on D8.
    - params: dirRight = 1, backTime 1 s, alignTimeout 2 s
    - model: cliff pins swapped (left D7, right D8); wander curves; deployed OK
    - wiring map and README updated
    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
2026-10-30 Edge v1.1 script + shorter wander steps and real small turns
    - edge_simplify.m: Stop -> Backward -> turn AWAY from the void -> Wander
    (the old alignment drove along the edge and often fell); adds turnTime,
    removes alignTimeout
    - motionGen: a turn = one wheel forward, the other stopped
    - params: wanderGo 0.3-0.6 s, speedWander 0.4, turnTime 0.8 s
    (model .slx updated once the script has been run on the PC)
    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
2026-10-30 Full English README (2WD-car style), MIT license, scripts use the English block names
    The model rename (Motors, Battery, Touch sensor, Cliff sensors, Sound player) and the
    README screenshots follow in the next commit, once run on the PC.
    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
2026-10-30 English block names (Motors, Battery, Touch sensor, Cliff sensors, Sound player), README screenshots, wanderWait 60
    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
2026-10-30 Update color description in 3D printing section
